wedgeat/ehrenpreis/hardware/EHRENPREIS.jpg

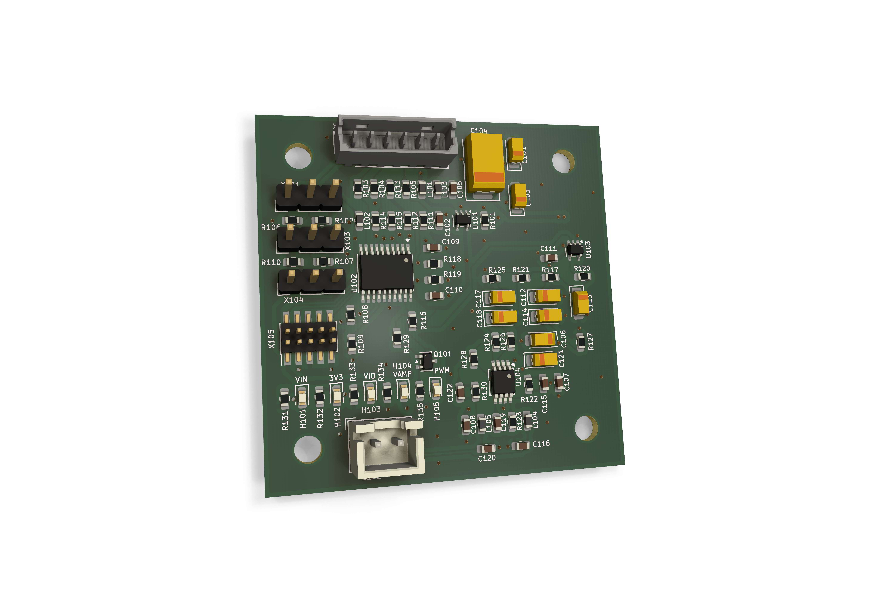
hardware/EHRENPREIS.jpg
