wedgeat/ehrenpreis/hardware/plot_sch/EHRENPREIS.pdf

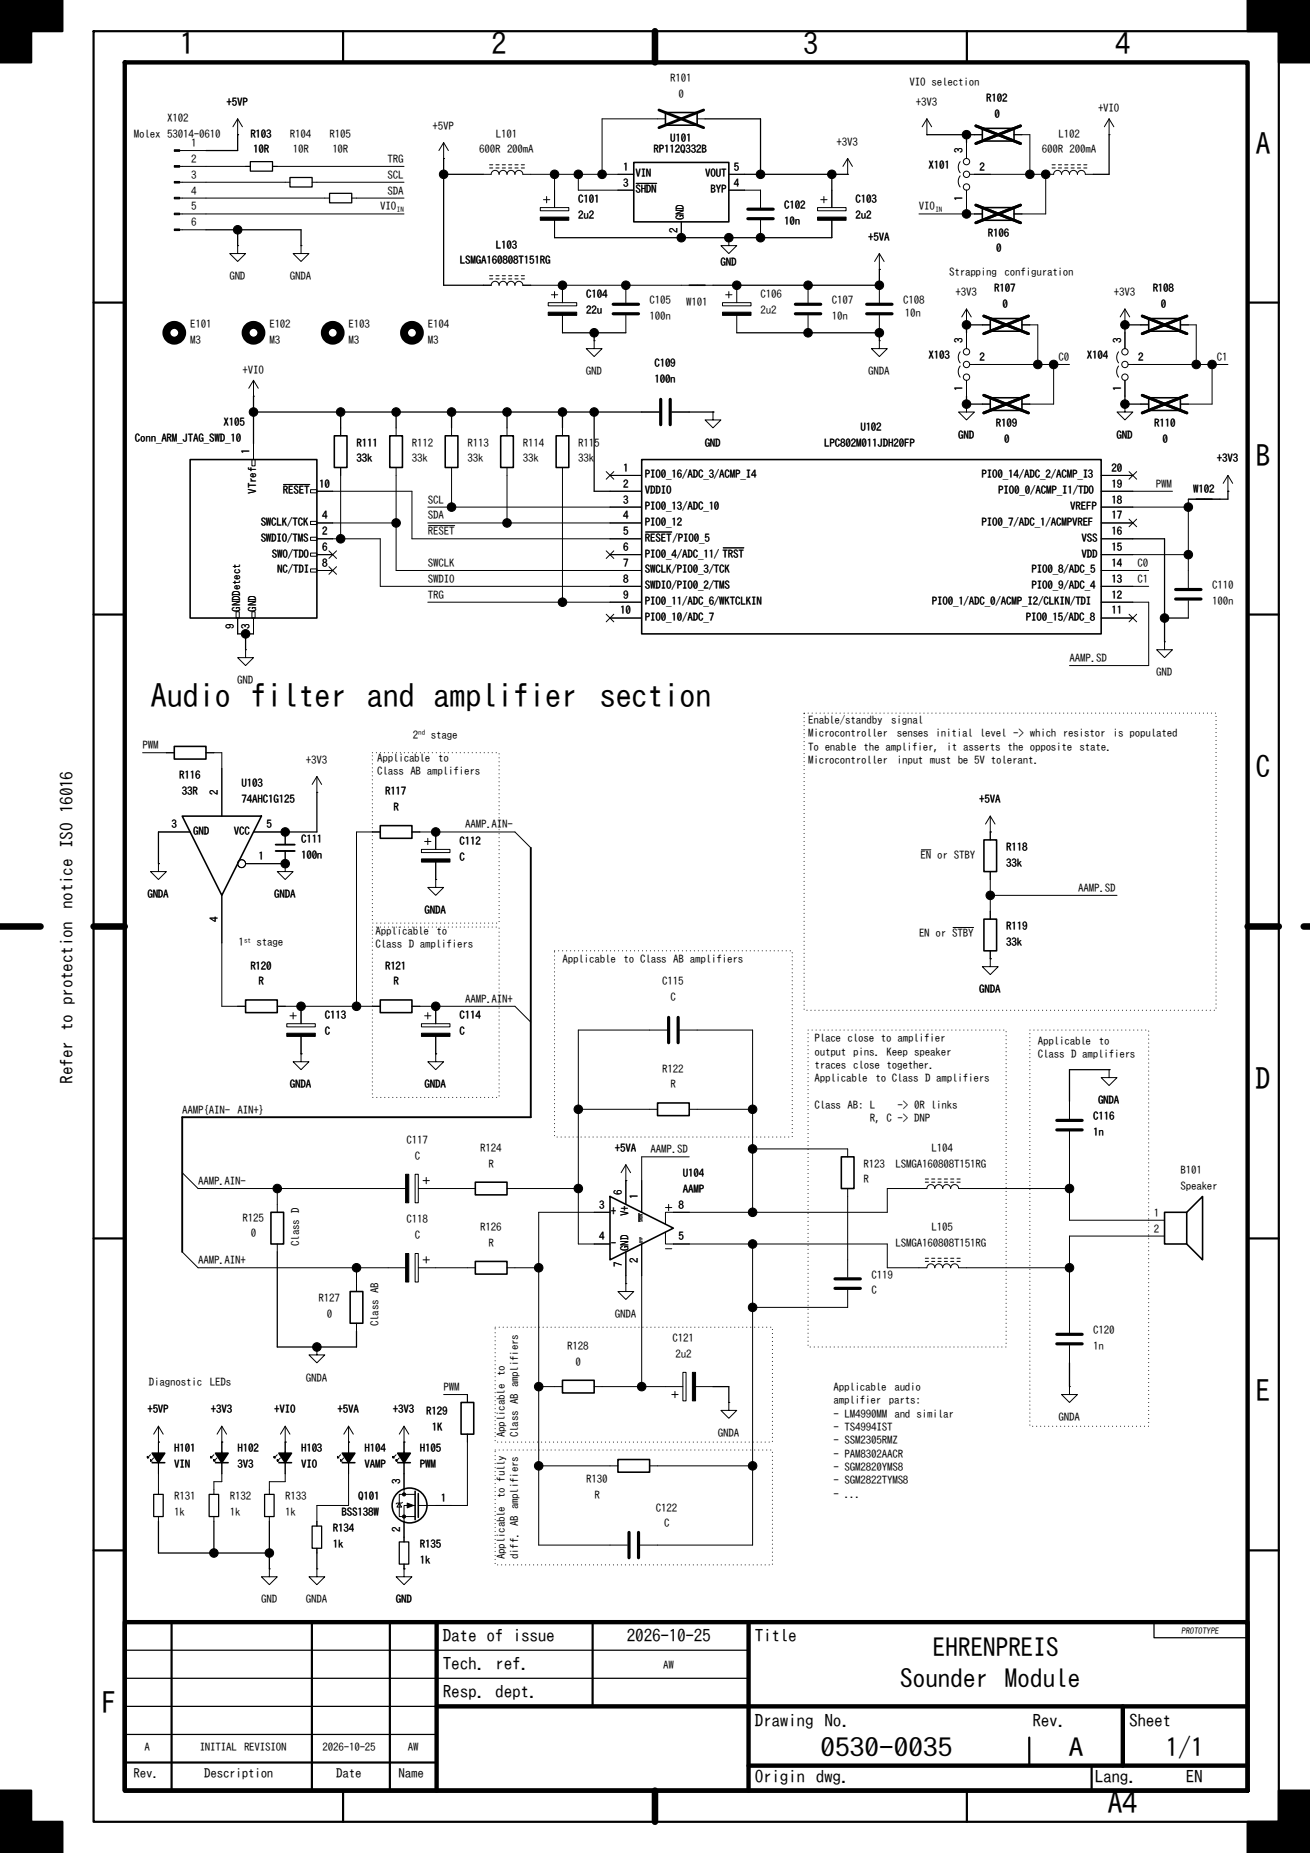
[picture p2: page 1]

Enable/standby signal
Microcontroller senses initial level -> which resistor is populated
To enable the amplifier, it asserts the opposite state.

Microcontroller input must be 5V tolerant. Class D

1/1 Refer to protection notice ISO 16016

Applicable to Class AB amplifiers

Place close to amplifier
output pins. Keep speaker
traces close together.
Applicable to Class D amplifiers

EHRENPREIS Sounder Module

Tech. ref. | AW
Resp. dept.

Drawing No. Rev. | Sheet

Lang. EN
