wedgeat/ehrenpreis/hardware/EHRENPREIS.kicad_pcb

## KiCad design hardware/EHRENPREIS.kicad_pcb (2026-11-08)

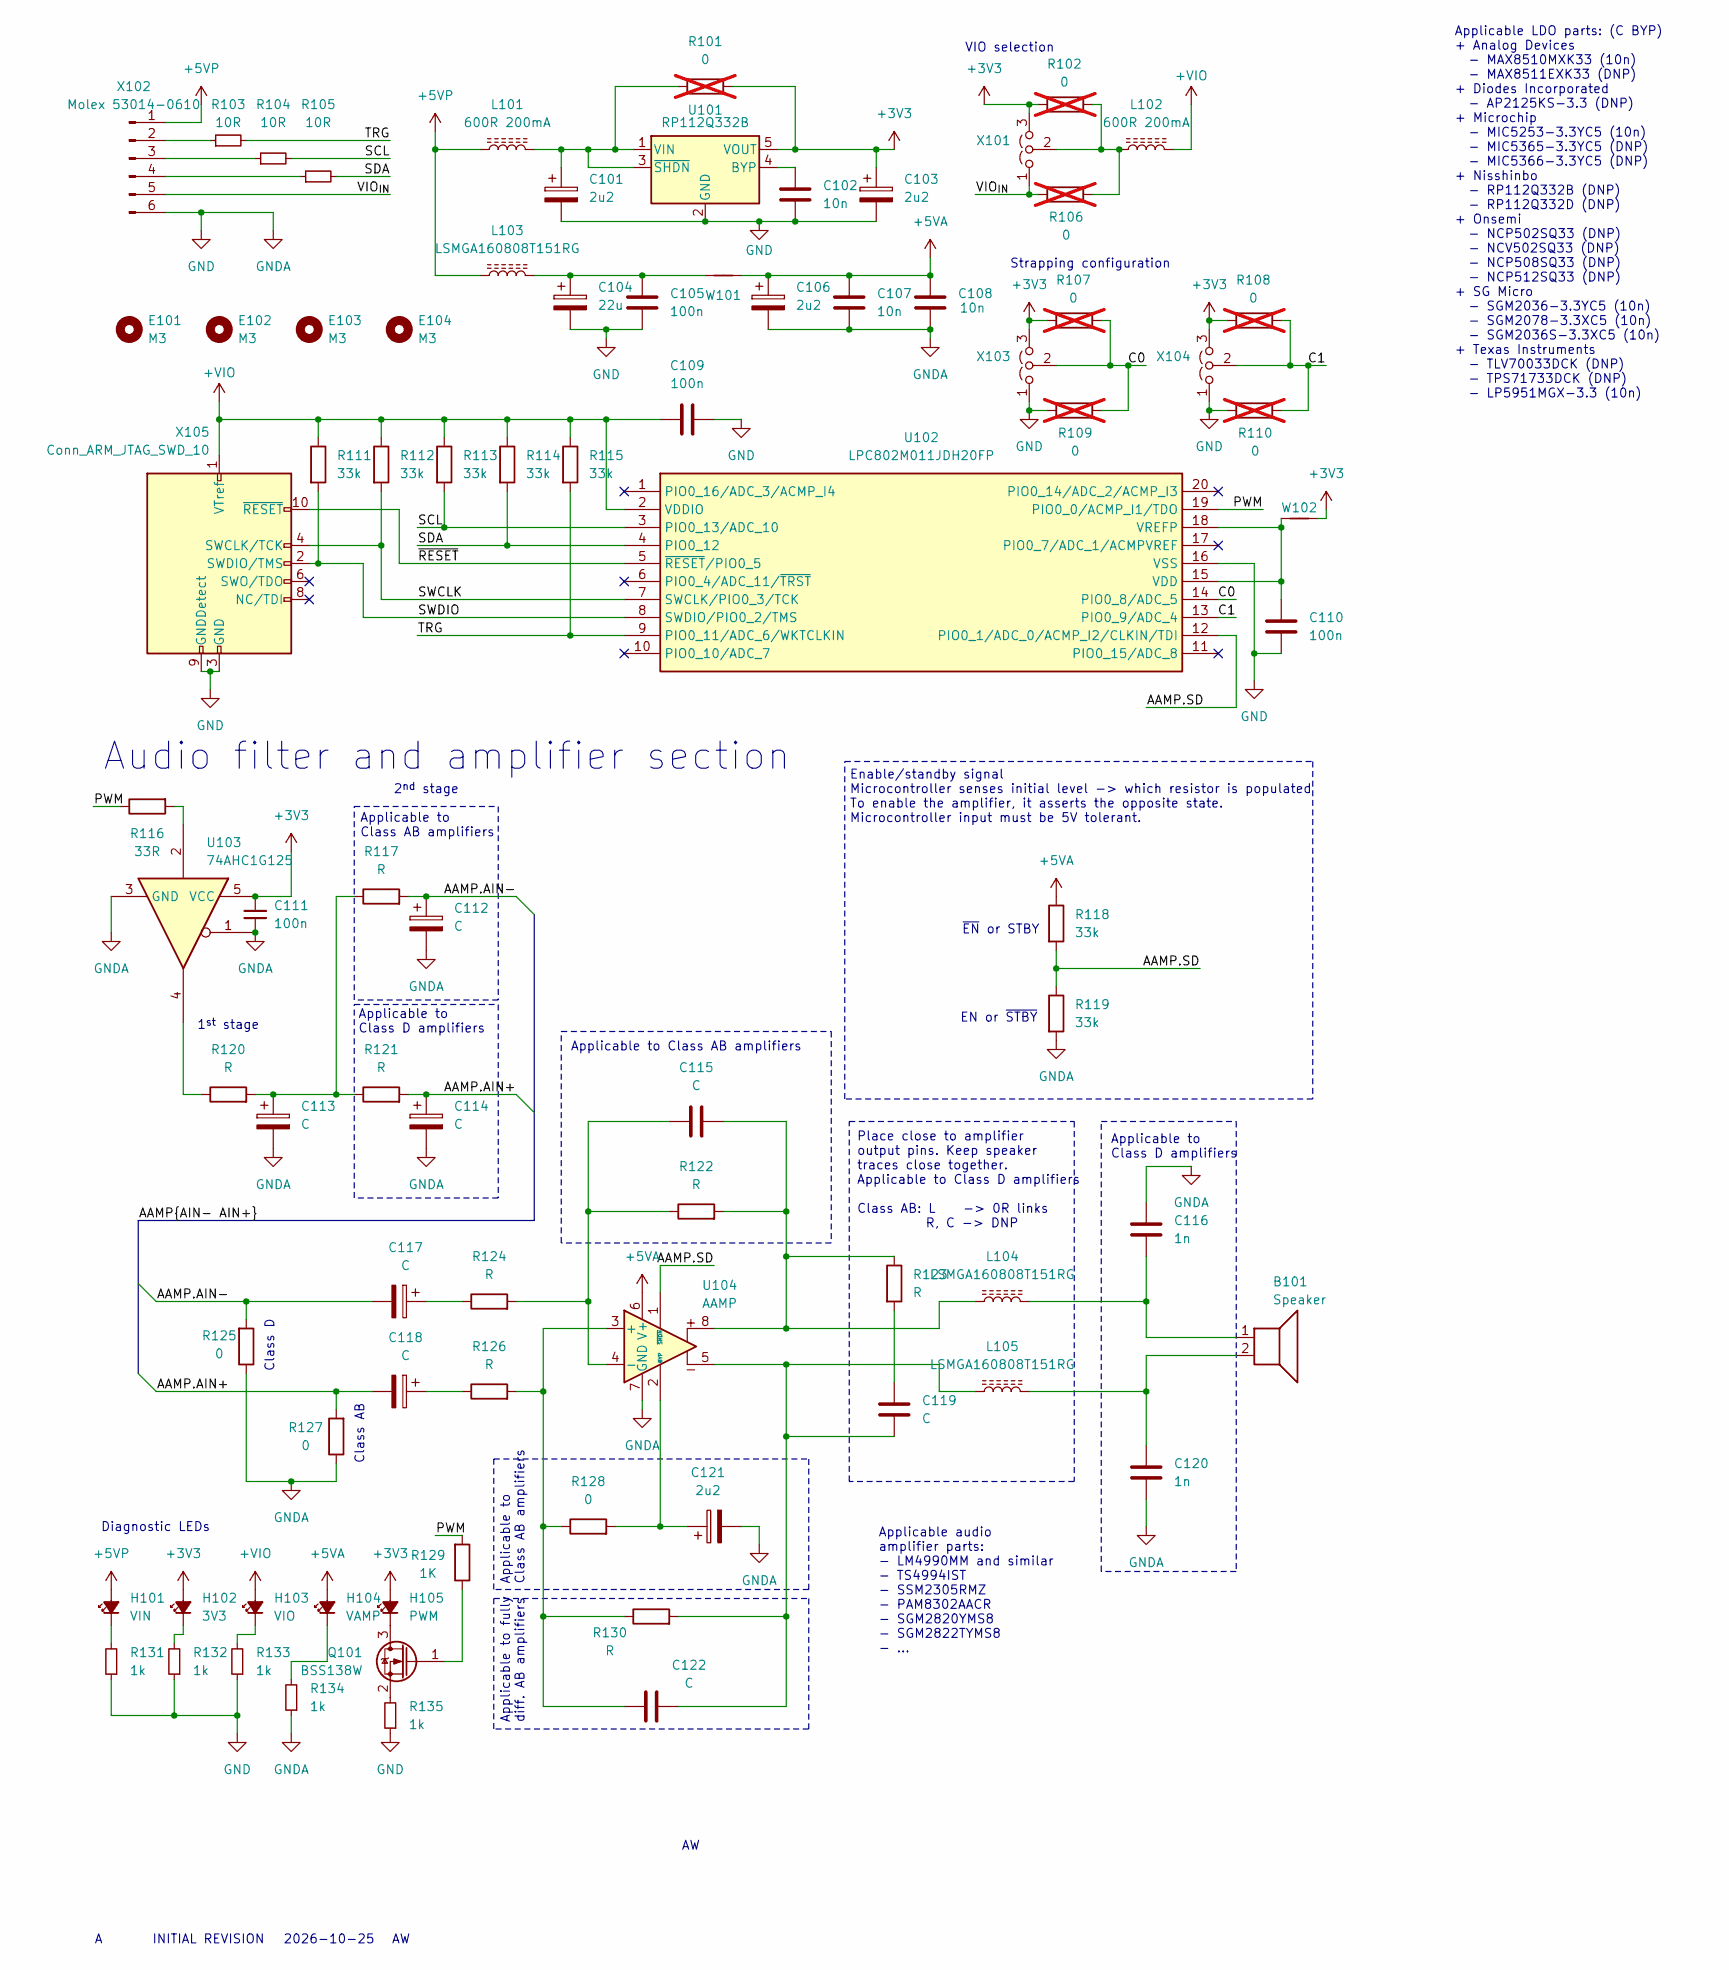
[picture p3: schematic EHRENPREIS.kicad_sch, Sounder Module]

Parts:
B101: Speaker; JST_XH_B2B-XH-A_1x02_P2.50mm_Vertical
C101, C103, C106, C121: 2u2; CP_EIA-3216-18_Kemet-A
C102, C107, C108: 10n; C_0603_1608Metric
C104: 22u; CP_EIA-7343-31_Kemet-D
C105, C109, C110, C111: 100n; C_0603_1608Metric
C112, C113, C114, C117, C118: C; CP_EIA-3216-18_Kemet-A
C115, C119, C122: C; C_0603_1608Metric
C116, C120: 1n; C_0603_1608Metric
E101, E102, E103, E104: M3; MountingHole_3.2mm_M3_DIN965
H101: VIN; LED_0603_1608Metric
H102: 3V3; LED_0603_1608Metric
H103: VIO; LED_0603_1608Metric
H104: VAMP; LED_0603_1608Metric
H105: PWM; LED_0603_1608Metric
L101, L102: 600R 200mA; L_0603_1608Metric
L103, L104, L105: LSMGA160808T151RG; L_0603_1608Metric
Q101: BSS138W; SOT-323_SC-70
R101, R102, R106, R107, R108, R109, R110: 0; R_0603_1608Metric; not fitted
R103, R104, R105: 10R; R_0603_1608Metric
R111, R112, R113, R114, R115, R118, R119: 33k; R_0603_1608Metric
R116: 33R; R_0603_1608Metric
R117, R120, R121, R122, R123, R124, R126, R130: R; R_0603_1608Metric
R125, R127, R128: 0; R_0603_1608Metric
R129: 1K; R_0603_1608Metric
R131, R132, R133, R134, R135: 1k; R_0603_1608Metric
U101: RP112Q332B; SOT-353_SC-70-5
U102: LPC802M011JDH20FP; TSSOP-20_4.4x6.5mm_P0.65mm; Manufacturer_Part_Number LPC802M011JDH20FP; Mouser Part Number 771-LPC802M011JDH20F
U103: 74AHC1G125; SOT-353_SC-70-5
U104: AAMP; TSSOP-8_3x3mm_P0.65mm
W101, W102: NetTie_2; NetTie-2_SMD_Pad0.5mm
X101: VIO; PinHeader_1x03_P2.54mm_Vertical
X102: Molex 53014-0610; SHDR6W60P0X200_1X6_1400X435X585P
X103: C0; PinHeader_1x03_P2.54mm_Vertical
X104: C1; PinHeader_1x03_P2.54mm_Vertical
X105: Conn_ARM_JTAG_SWD_10; PinHeader_2x05_P1.27mm_Vertical_SMD

Connections:
+3V3: C103.1, C111.1, H102.2 (A), H105.2 (A), R101.2, R102.2, R107.2, R108.2, U101.5 (VOUT), U103.5 (VCC), W102.1, X101.3 (B), X103.3 (B), X104.3 (B)
+5VA: C106.1, C107.1, C108.1, H104.2 (A), R118.1, U104.6 (V+), W101.1
+5VP: H101.2 (A), L101.1, L103.1, X102.1
+VIO: C109.1, H103.2 (A), L102.2, R111.1, R112.1, R113.1, R114.1, R115.1, U102.2 (VDDIO), X105.1 (VTref)
/AAMP.AIN+: C114.1, C118.2, R121.2, R127.2
/AAMP.AIN-: C112.1, C117.2, R117.2, R125.2
/AAMP.SD: R118.2, R119.1, U102.12 (PIO0_1/ADC_0/ACMP_I2/CLKIN/TDI), U104.1 (~SHDN)
/C0: R107.1, R109.1, U102.14 (PIO0_8/ADC_5), X103.2 (C)
/C1: R108.1, R110.1, U102.13 (PIO0_9/ADC_4), X104.2 (C)
/PWM: R116.1, R129.2, U102.19 (PIO0_0/ACMP_I1/TDO)
/SCL: R104.2, R113.2, U102.3 (PIO0_13/ADC_10)
/SDA: R105.2, R114.2, U102.4 (PIO0_12)
/SWCLK: R112.2, U102.7 (SWCLK/PIO0_3/TCK), X105.4 (SWCLK/TCK)
/SWDIO: R111.2, U102.8 (SWDIO/PIO0_2/TMS), X105.2 (SWDIO/TMS)
/TRG: R103.2, R115.2, U102.9 (PIO0_11/ADC_6/WKTCLKIN)
/VIO_{IN}: R106.2, X101.1 (A), X102.5
/~RESET: U102.5 (~RESET/PIO0_5), X105.10 (~RESET)
GND: C101.2, C102.2, C103.2, C104.2, C105.2, C106.2, C107.2, C108.2, C109.2, C110.2, C111.2, C112.2, C113.2, C114.2, C116.1, C120.2, C121.2, R109.2, R110.2, R119.2, R125.1, R127.1, R131.1, R132.1, R133.1, R134.1, R135.1, U101.2 (GND), U102.16 (VSS), U103.1, U103.3 (GND), U104.7 (GND), X102.6, X103.1 (A), X104.1 (A), X105.3 (GND), X105.5 (GND), X105.9 (GNDDetect)
unnamed: B101.1, C116.2, L104.2
unnamed: B101.2, C120.1, L105.2
unnamed: C104.1, C105.1, L103.2, W101.2
unnamed: C113.1, R117.1, R120.2, R121.1
unnamed: C115.2, L104.1, R122.2, R123.1, U104.8
unnamed: C117.1, R124.1
unnamed: C118.1, R126.1
unnamed: C119.1, R123.2
unnamed: C119.2, C122.2, L105.1, R130.2, U104.5
unnamed: H101.1 (K), R131.2
unnamed: H102.1 (K), R132.2
unnamed: H103.1 (K), R133.2
unnamed: H104.1 (K), R134.2
unnamed: H105.1 (K), Q101.3 (D)
unnamed: Q101.1 (G), R129.1
unnamed: Q101.2 (S), R135.2
unnamed: R116.2, U103.2
unnamed: R120.1, U103.4
unnamed: C102.1, U101.4 (BYP)
unnamed: C101.1, L101.2, R101.1, U101.1 (VIN), U101.3 (~SHDN)
unnamed: C110.1, U102.15 (VDD), U102.18 (VREFP), W102.2
unnamed: C122.1, R126.2, R128.1, R130.1, U104.3 (+)
unnamed: C115.1, R122.1, R124.2, U104.4 (-)
unnamed: C121.1, R128.2, U104.2 (BYP)
unnamed: L102.1, R102.1, R106.1, X101.2 (C)
unnamed: R103.1, X102.2
unnamed: R104.1, X102.3
unnamed: R105.1, X102.4

Notes on the sheet:
2^{nd} stage
Applicable to Class D amplifiers
Place close to amplifier output pins. Keep speaker traces close together. Applicable to Class D amplifiers Class AB: L -> 0R links R, C -> DNP
Diagnostic LEDs
1^{st} stage
EN or ~{STBY}
Applicable to fully diff. AB amplifiers
Class D
Class AB
Strapping configuration
Audio filter and amplifier section
2026-10-25
Applicable to Class AB amplifiers
Applicable to Class AB amplifiers
Applicable LDO parts: (C BYP) + Analog Devices - MAX8510MXK33 (10n) - MAX8511EXK33 (DNP) + Diodes Incorporated - AP2125KS-3.3 (DNP) + Microchip - MIC5253-3.3YC5 (10n) - MIC5365-3.3YC5 (DNP) - MIC5366-3.3YC5 (DNP) + Nisshinbo - RP112Q332B (DNP) - RP112Q332D (DNP) + Onsemi - NCP502SQ33 (DNP) - NCV502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
~{EN} or STBY
VIO selection
INITIAL REVISION
Enable/standby signal Microcontroller senses initial level -> which resistor is populated To enable the amplifier, it asserts the opposite state. Microcontroller input must be 5V tolerant.
Applicable audio amplifier parts: - LM4990MM and similar - TS4994IST - SSM2305RMZ - PAM8302AACR - SGM2820YMS8 - SGM2822TYMS8 - ...

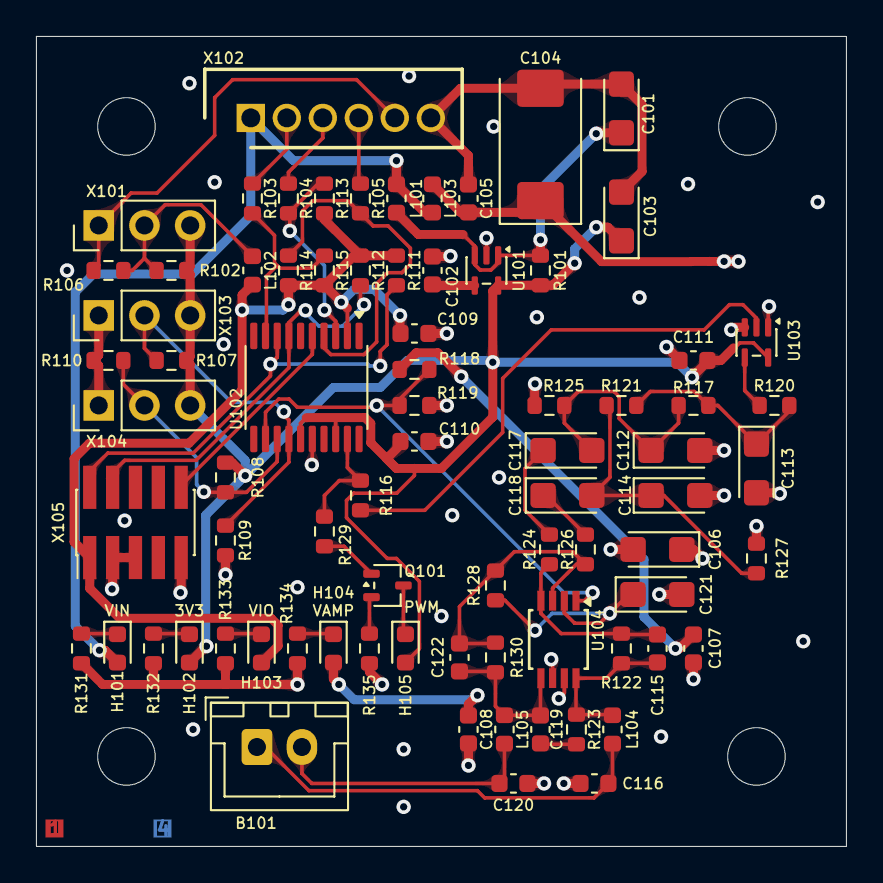
[picture p4: board EHRENPREIS.kicad_pcb from above]

Board: 4 copper layers, 45.0 x 45.0 mm, 84 parts (0 on the bottom side), 46 nets.
